Hamza140926/Station-de-surveillance-atmosph-rique/(list of files, drawings)

Other design files:
Project.pdsprj
