Hamza140926/Station-de-surveillance-atmosph-rique/(commit log)

2026-10-16 Add atmospheric monitoring project and Proteus setup documentation
    [Project.pdsprj]
2026-10-18 Migrate station to nRF24L01 and document final Proteus project
    [Project.pdsprj]
2026-10-18 Fix wireless circuit image filename and README links
2026-10-27 Document and validate station communication protocols
    Add the complete project report, restore the UART reference firmware, include standalone nRF24L01 tests, and align the radio diagnostics and Proteus documentation.
    [Project.pdsprj]
